yonizvida-gif/Drone-Project-Michael-Yoni/README.md

# ESP32-S3 Quadcopter Flight Controller

## Project Overview
This project implements a real-time flight controller for a quadcopter based on the ESP32-S3 microcontroller.
The system integrates control algorithms, sensor fusion, and wireless communication into a complete
hardware-firmware solution, developed and tested on a real platform.

## System Architecture
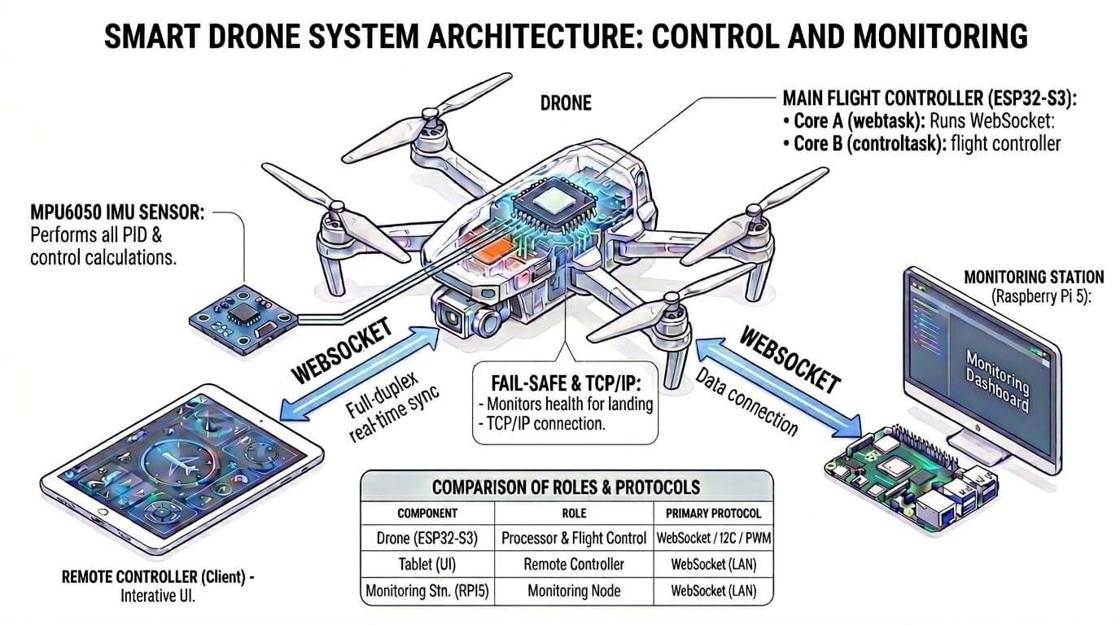
[picture p1: system_architecture_drone.png]
System Architecture


The flight controller leverages the **ESP32-S3 dual-core architecture** to separate critical tasks:
- **Core A (webtask):** Telemetry & Commands Handling.
- **Core B (controltask):** Flight Control & PID Loop.
  
 ## 🖥️ System Interfaces

| **Ground Station (RPi 5)** | **Mobile Controller** |
| :---: | :---: |
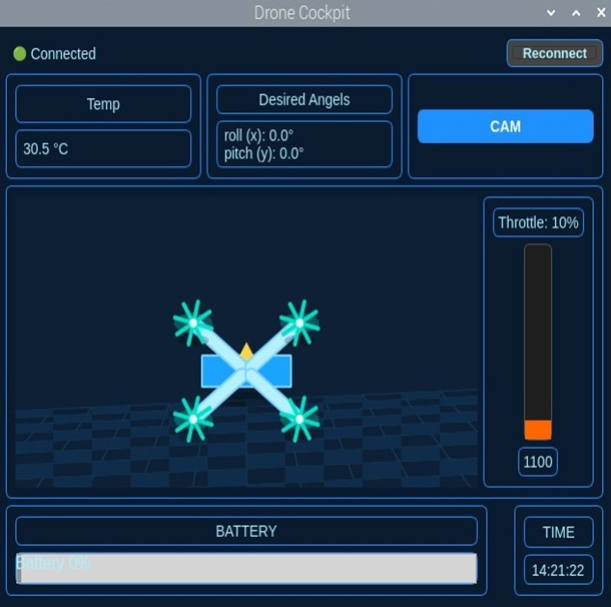
[picture p2: RaspberryPi_App/dashboard.png]
Dashboard
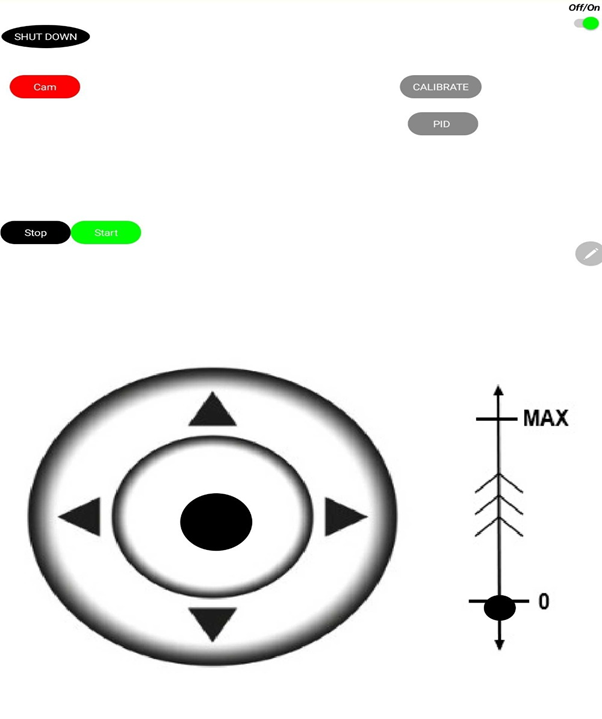
[picture p3: Remote_Controller/remote_gui.png]
Remote
|  |  |
| Real-time 3D Telemetry | Low-latency Manual Flight Control |

## Key Features
- Real-time PID flight control
- Sensor fusion using IMU data
- Wireless control and telemetry over Wi-Fi
- Full hardware-firmware integration

## Repository Structure
- ESP32_FlightController        – ESP32-S3 flight controller firmware (C++)
- Final_Project_Report_Book     – Project documentation and report
- RaspberryPi_App               – Raspberry Pi 5 control application
- Remote_Controller             – Mobile remote control application (MIT App Inventor source)

## Tools & Technologies
- Languages: C++, Python
- Protocols: I2C, UART, PWM, WebSockets
- Algorithms: Kalman Filter, PID Control, Sensor Fusion
- Platforms: ESP32-S3, Raspberry Pi 5, MIT App Inventor
