yonizvida-gif/Drone-Project-Michael-Yoni/(commit log)

2025-10-09 Add ESP32 and remote controller code
2025-10-10 Add Raspberry Pi code
2025-10-10 Add ESP32 text file
2025-10-14 Add PID calibration videos
2025-10-14 Add Test_Flights folder with videos for ESP32 flight controller
2025-10-15 Update ESP32 flight controller code with new PID tuning
2025-10-17 Add test flight video to ESP32_FlightController/Test_Flights
2026-04-06 Create Motor_Calibration
